timschloemer109-max/rc-schleppseilwinde-v2/docs/todo.md

# Offene Punkte, Messungen und Tests

## V3.0-Entwicklung ab 2026-10-07

Maßgeblicher Zielstand: [software_v3_0.md](software_v3_0.md). Ausführbarer Auftrag: [codex_v3_0_auftrag.md](codex_v3_0_auftrag.md).

- Entwicklungsordner `entwicklung/seilwinde_v3/` mit Firmware, Core, Tests, Simulator, Hardware und Berichten aufbauen.
- Nano-R4-Core, UART/Half-Duplex, Timer/Servo, ADC und Persistenz qualifizieren; JetiExBus besitzt noch kein R4-Backend.
- Steuerungskern und EX-Bus-Parser auf dem Host testen; blockierende PWM-Lesungen ersetzen.
- Kanaldaten, Telemetrie, JETIBOX-Einstellungen, Softstart und versionierte Parameter umsetzen.
- uniLIGHT-Durchleitung/Warnung und High-Side-Leistungsschalter-Schnittstelle mit sicheren Defaults planen und testen.
- Hauptfirmware-CSV implementieren und gegen den vorhandenen Pi-Logger prüfen; bisherige Doku ist Ziel, kein Nachweis der Ausgabe.
- JETI-Studio-Senderemulator prüfen; EX-Bus-Testmaster mit unabhängigen Referenztelegrammen und Fehlerfällen ergänzen.
- Hosttests, R4-Build und CI reproduzierbar machen; echte Hardwaretests separat protokollieren.
- RC→5-V-Wandler für aktuelle 6 V / späteres HV auswählen; Einbau, Ripple, EMV, Einschaltfolgen und Rückspeisung prüfen.

## Vor dem ersten Flugbetrieb

- Hall-Sensor-Typ und Magnetposition festlegen
- Magnetanzahl final festgelegt: `2`
- Magnetorientierung dokumentiert: `2` Magnete, `180 Grad` versetzt, gleiche Polrichtung
- Anzahl Hall-Pulse pro Trommelumdrehung gemessen: `2`
- ESC-Typ und separate RC→5-V-Steuerungsversorgung dokumentieren; ESC-BEC bleibt unbenutzt
- `Turnigy Plush 30A` im Aufbau dokumentieren
- reale ACS712-Nullpunkt- und Lastwerte weiter messen und in `docs/calibration.md` nachfuehren
- langsame PWM fuer sicheren Endanlauf einmessen
- Stromgrenze fuer normalen Zug und fuer echten Stall erst nach Seiltests final festlegen
- erster echter Lernwert aufgezeichnet: `321` Hall-Pulse
- Rasen-Lernfahrt dokumentiert: `337` Hall-Pulse, geglaetteter Lernwert danach `347.1`
- Lizenz fuer oeffentliche GitHub-Nutzung festlegen

## Hardware-Tests

- EMV- und RC-Stoerthema aktiv weiterverfolgen: siehe `docs/emv_rc_stoerungen.md`
- ESP32-Sniffer fuer `D4 -> ESC` aufbauen und Vergleichsmessungen `Motor aus / Motor an / Motor an mit Gas` aufzeichnen
- ESP32-Nachweis fuer `D4 -> ESC` dokumentiert: `Motor aus` sauber, `Motor an` mit `OUT_OF_RANGE` und `TIMEOUT`
- Killswitch der Zuendung als Stoerkandidat gezielt gegen direkten Akkuanschluss der Zuendung vergleichen
- Vergleich mit direkter Zundungsversorgung dokumentiert: Signal fast sauber, Killswitch-Pfad weiter zerlegen
- Empfaengerkanal vor dem Arduino dokumentiert: `Motor aus` sauber, `Motor an` mit Killswitch bereits stoerbehaftet
- Killswitch-Stecker Richtung Empfaenger dokumentiert: direkte Stoerpulse messbar, Kontroll-LED zeigte Fehlverhalten
- neuen Killswitch beschaffen und den kompletten Vergleichsablauf danach wiederholen
- Endschalter elektrisch und mechanisch geprueft, erster echter Seilweg-Endtest erfolgreich
- Werkbank-Testbench ohne Seil mit angeschlossenem Motor pruefen
- Hall-Signal mit langsamer und hoher Drehzahl pruefen
- Stoerfestigkeit der 5-V-Schiene unter Motorlast pruefen
- getrennte Arduino-Versorgung gegen gemeinsame Masse-/Signalstoerung abgrenzen und dokumentieren
- Temperaturverhalten von ACS712 und ESC pruefen
- Leitungsfuehrung auf Stoereinkopplung pruefen

## Firmware-Tests

- Testbench: `ARM`, `STOP`, `SET`, `SWEEP`, `STATUS` und `ZERO` pruefen
- Testbench: CSV-Ausgabe auf Vollstaendigkeit und Plausibilitaet pruefen
- erster Lasttest mit aufgezeichneter CSV gegen `docs/calibration.md` dokumentiert
- erster Stalltest mit aufgezeichneter CSV gegen `docs/calibration.md` dokumentiert
- Hauptfirmware: ACS712 vorerst nur beobachten, spaeter wieder als Fehlerkriterium zuschalten
- Endschalter-Latch und Ruecksetzung ueber `RESET/LEARN` dokumentiert
- Hauptfirmware: Laufzeit-Failsafe voruebergehend auf `60000 ms` fuer langsames Aufwickeln gesetzt
- erstes langsames Aufwickeln mit echtem Seil und aktivem Endschalter dokumentiert
- Lernen mit voller Abrollstrecke erfolgreich dokumentiert
- pulsgesteuerte Umschaltung FAST -> SLOW mit Lernwert erfolgreich dokumentiert
- Weiterlaufen nach Rueckkehr des Schalters in die Mitte erfolgreich dokumentiert
- Signalverlust eines RC-Kanals waehrend des Laufs erfolgreich dokumentiert
- RC-Glitch-Test mit laufendem Verbrenner: kurzer Einzel-Aussetzer darf keinen gelatchten `RC_SIGNAL_LOSS` mehr ausloesen
- Einschalten mit Trigger in Mitte und normalem ESC-Schaerfen pruefen
- Einschalten mit Trigger auf `RUN`: keine Bewegung bis Mitte und neuer `RUN`
- Einschalten mit Trigger auf `RESET/LEARN`: keine Lernfahrt bis Mitte
- Arduino vor ESC, ESC vor Arduino und nahezu gleichzeitig pruefen
- kein langsames Phantom-Einziehen nach manuellem Seil-Ausziehen und Loslassen
- sauberer Stopp am Endschalter
- Stall-Test mit absichtlicher Blockade
- hohe Last bei drehender Trommel ohne Fehlabschaltung
- Laufzeit-Failsafe
- kurzer Reset ohne Speichern
- Neustart mitten im Einfahrweg mit neuer Restweg-Logik praktisch erfolgreich geprueft
- teilweise Lernfahrt unterhalb der neuen `70 %`-Schwelle erfolgreich verworfen
- gespeicherte Seillaenge nach Arduino-Neustart gegen EEPROM-Inhalt und Laufverhalten erfolgreich geprueft
- Rasentest auf Rasen mit regulaerem Endschalter-Stopp und Peakstrom von etwa `5.03 A` dokumentiert

## Naechste Software-Schritte

- Begleitdatei fuer Stoer- und RC-Aussetzer-Thema pflegen: `docs/emv_rc_stoerungen.md`
- Diagnosepaket `tools/esp32-logger` bei Bedarf auf `RC Trigger` und `RC Speed` erweitern
- optional RC-Eingaenge spaeter auf Interrupt oder Pin-Change umstellen
- Testbench-Messdaten spaeter fuer Anlauf-PWM und Stromgrenzen auswerten
- `docs/calibration.md` nach weiteren Seil- und Lasttests weiterpflegen
- EEPROM-Struktur spaeter versionieren, falls weitere Parameter gespeichert werden
- pruefen, ob Endschalter auf fail-safe-NC umgestellt werden soll
- bei Brushless-Aufbau eventuell feinere Rampen oder Softstart ergaenzen
- weitere Abwickeltests im Freifeld mit Laengenvergleich gegen den Lernwert dokumentieren
- Beobachtungsregel fuer Fahrtests bei Bedarf spaeter ins README uebernehmen
- Bootsignal an `D4` bei Bedarf mit Oszi oder Logikanalysator messen
- optionalen Serienwiderstand oder Pulldown am ESC-Signal nur bei echtem Restproblem pruefen
- 5-V-Verhalten beim manuellen Rueckdrehen oder Ausziehen weiter beobachten
