timschloemer109-max/rc-schleppseilwinde-v2/(commit log)

2026-04-06 Refine hardware docs and add schematic
2026-04-11 Add testbench workflow and calibrate V2 firmware
2026-04-12 Document end switch and first rope winding test
2026-04-15 Robustify ESC startup and tune slow phase
2026-04-16 Document grass test current measurements
2026-04-20 Document EMV findings and add ESP32 PWM logger
    [esp32_d4_motor_off_20260420_202147.csv, esp32_d4_motor_on_20260420_201936.csv, esp32_d4_motor_on_60s_20260420_202514.csv, esp32_d4_motor_on_direct_ignition_20260420_203212.csv, esp32_killswitch_rxplug_30s_20260420_205018.csv, esp32_rx_channel_motor_off_20260420_204044.csv, esp32_rx_channel_motor_on_killswitch_20260420_204232.csv]
